tigard-tools/xiaomao/xiaomao-render.png

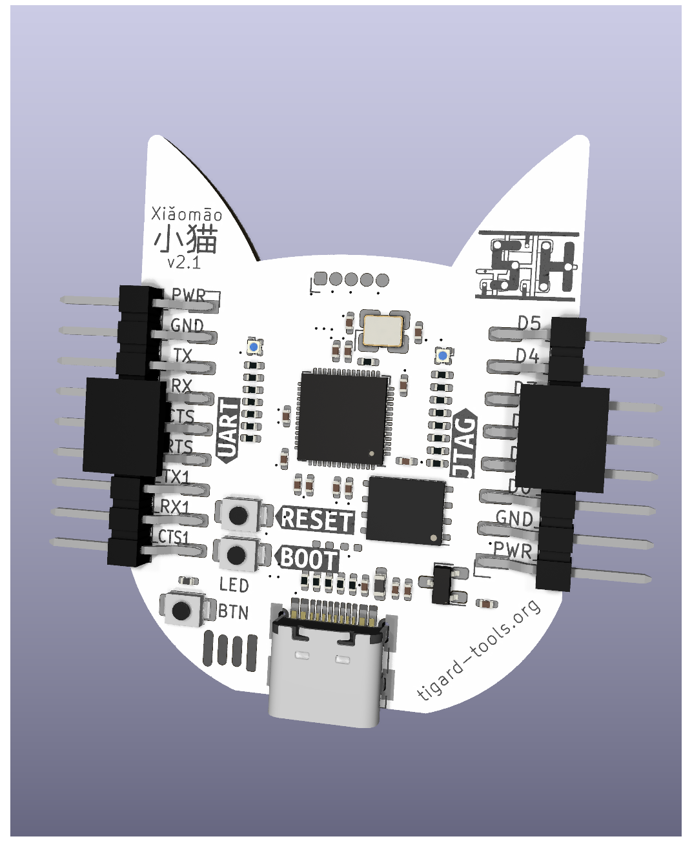
xiaomao-render.png
