tigard-tools/xiaomao/b3u-1000p-b.stp

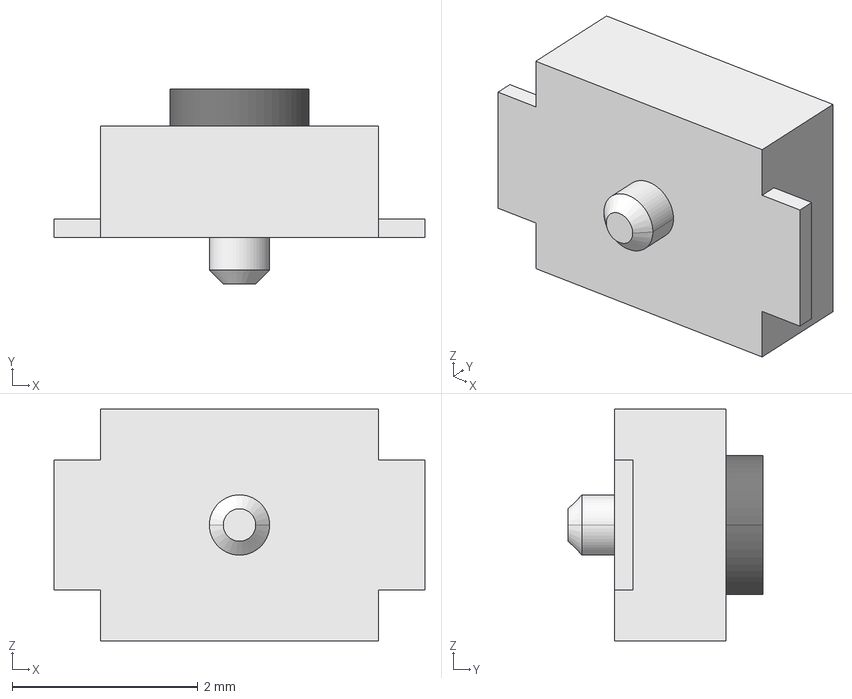
[picture p2: CAD file, 2026-04-09]
b3u-1000p-b.stp
4.00 x 2.10 x 2.50 mm
