tigard-tools/xiaomao/(commit log)

2021-09-10 first rough version of board for prototyping
    [xiao-addon.kicad_pcb, xiao-addon.sch]
2021-09-12 Move old design
    [xiao-addon.kicad_pcb, xiao-addon.sch]
2021-09-13 Preliminary design work
    [Seeeduino Xiao.step, xiaotagulator.kicad_pcb, xiaotagulator.sch]
2021-09-13 Cleanup, SWD labels
    [xiaotagulator.kicad_pcb]
2021-09-13 Cleanup (round SWD pin 1)
    [xiaotagulator.kicad_pcb]
2021-09-13 Add v0.1 version number, fix paths
    [xiaotagulator.kicad_pcb]
2021-09-13 Last adjustments before prototype order
    [xiaotagulator.kicad_pcb, xiaotagulator.sch]
2021-09-13 Rename xiaotagulator->xiaomao
    [xiaomao.kicad_pcb, xiaomao.sch]
2021-09-22 adding pcb render
2021-09-23 fixing 幼猫 to 小猫
    young cat vs small cat; both mean kitten and sound pretty similar (youmao vs xiaomao)
2021-10-12 Add SW_SPST hole
    [xiaomao.kicad_pcb, xiaomao.sch]
2023-07-13 fix xiao holes, add paste area
    [xiaomao.kicad_pcb]
2024-11-20 first pass swapping out xiao for an rp2040 circuit borrowed from opentaxus
    [xiaomao.kicad_pcb, xiaomao.kicad_sch, xiaomao.sch]
2024-11-23 fixing loose power and ground wires for the headers
    [xiaomao.kicad_sch]
2024-11-23 cleaned up erc errors related to cut and pasting schematics
    [xiaomao.kicad_pcb, xiaomao.kicad_sch]
2024-12-28 adjust UART pinout, cleanup net names
    [xiaomao.kicad_sch]
2024-12-28 shrinking gpio resistors to 0402 for more space
    [xiaomao.kicad_sch]
2024-12-28 make bottom corners of pcb curvy
    [xiaomao.kicad_pcb]
2024-12-28 flip jtag header pin numbering, move neopixel pins
    [xiaomao.kicad_pcb]
2024-12-28 adjust outline to be more rounded catlike; condense parts to make room for labels on front and art on back; minimize through holes and vias
    [xiaomao.kicad_sch]
2025-02-17 fixup labels; line up resistors; move button;
    [xiaomao.kicad_pcb]
2025-02-17 switch over to eye footprint; other near final cleanup
    [xiaomao.kicad_pcb]
2025-02-17 trying to make usb/power passives prettier
    [xiaomao.kicad_pcb]
2025-02-18 final touchup for first production run
    [xiaomao.kicad_pcb]
2026-04-09 removing old seeed and xiaomao v1 resources
    [Seeeduino Xiao.step, xiao-addon.kicad_pcb, xiao-addon.sch]
2026-04-09 updating to kicad v9 and updating url
    [b3u-1000p-b.stp, xiaomao.kicad_pcb, xiaomao.kicad_sch]
2026-04-09 updating to kicad v9
2026-04-20 add button, change usb connector, move labels and buttons, bump revision
    [xiaomao.kicad_pcb, xiaomao.kicad_sch]
2026-04-22 added smt headers, new labels, button, and led; hand drawn cat face
    [xiaomao.kicad_pcb, xiaomao.kicad_sch]
2026-04-22 updating manufacturing info in schematic for prototype
    [xiaomao.kicad_sch]
2026-04-22 updating opart numbers for prototype order
    [xiaomao.kicad_sch]
2026-04-22 hiding schematic backup files
2026-04-22 replacing labels; adding led series resistor
    [xiaomao.kicad_pcb, xiaomao.kicad_sch]
2026-04-22 changed names of gpio nets to match labels and code
    [xiaomao.kicad_pcb, xiaomao.kicad_sch]
2026-04-24 final touchup of label positions for prototype order
    [xiaomao.kicad_pcb, xiaomao.kicad_sch]
2026-05-05 pad and soldermask improvements for production
    [xiaomao.kicad_pcb, xiaomao.kicad_sch]
2026-05-08 updating footprints and fields to match lbirarieswq
    [xiaomao.kicad_pcb, xiaomao.kicad_sch]
2026-05-26 adding new cat artwork; updating parts for productiony
    [xiaomao.kicad_pcb, xiaomao.kicad_sch]
2026-05-30 adding schottky diode and sending to fab
    [xiaomao.kicad_pcb, xiaomao.kicad_sch]
2026-10-06 Reorder and update readme for V2.1
    - Added V2.1 pins and names
    - updated circuitpython support
    - reordered and re-titled sections with most relevant usage info first and development info towards the end.
