tigard-tools/xiaomao/(notices)

Notices in the files:
xiaomao.kicad_pcb:
License: CERN-OHL-S-2.0
